m-r-s/hearingaid-prototype/signatures/README.md

Here only the GPG signatures are deployed.
If you don't know what this is, then you probably don't need them.

If you are looking for the image files:
https://github.com/m-r-s/hearingaid-prototype/wiki/Image#download
