m-r-s/hearingaid-prototype/images/controllerlayout.jpg

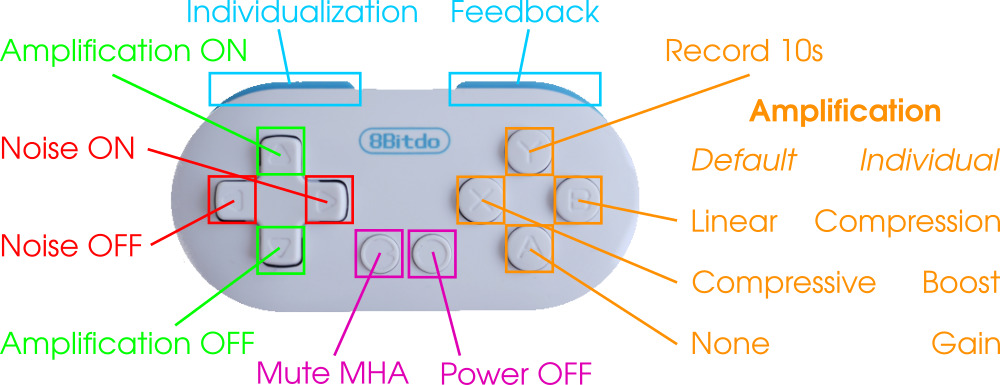
images/controllerlayout.jpg
