m-r-s/hearingaid-prototype/images/feedback-compensation.jpg

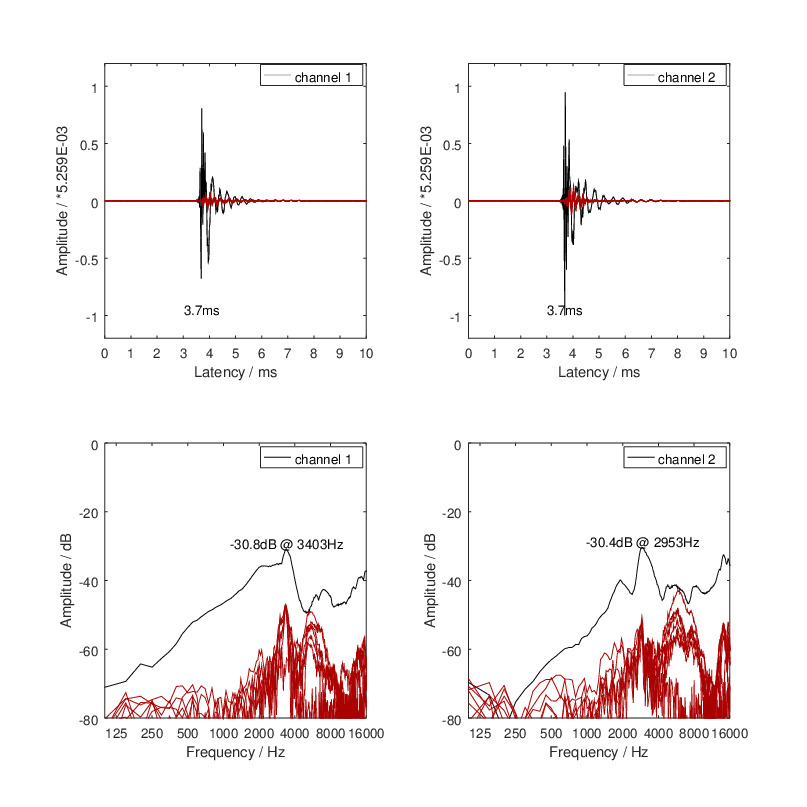
images/feedback-compensation.jpg
