m-r-s/hearingaid-prototype/images/feedback-example.jpg

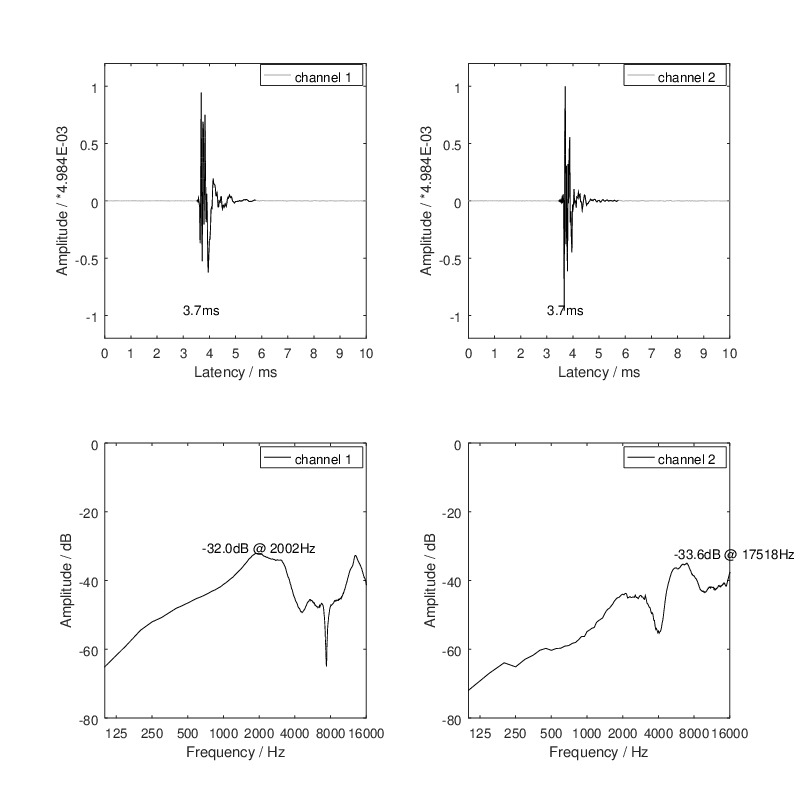
images/feedback-example.jpg
