m-r-s/hearingaid-prototype/images/feedback-relocate.jpg

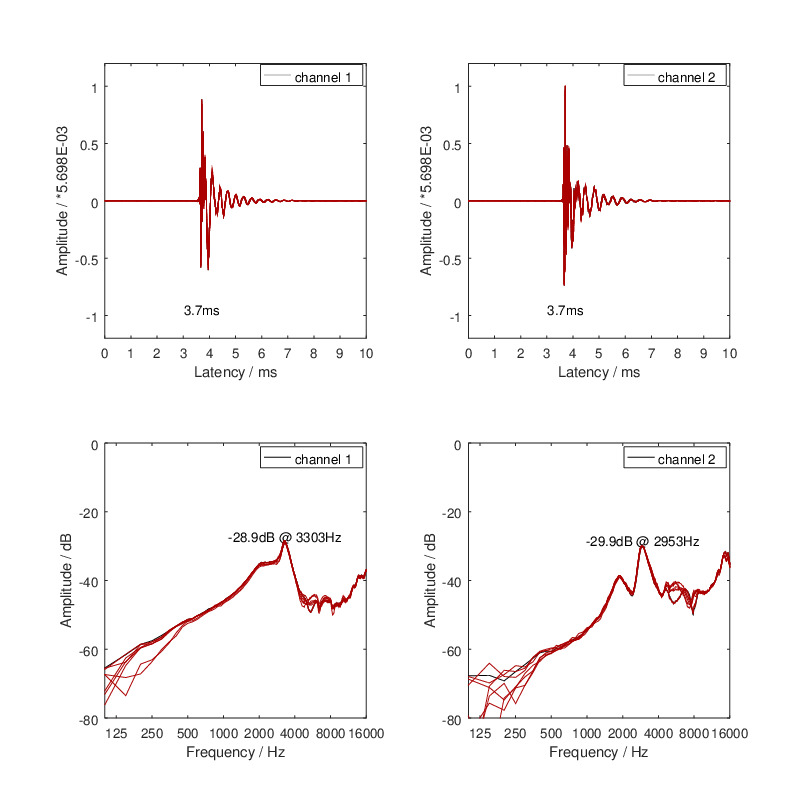
images/feedback-relocate.jpg
