m-r-s/hearingaid-prototype/images/gaintable.jpg

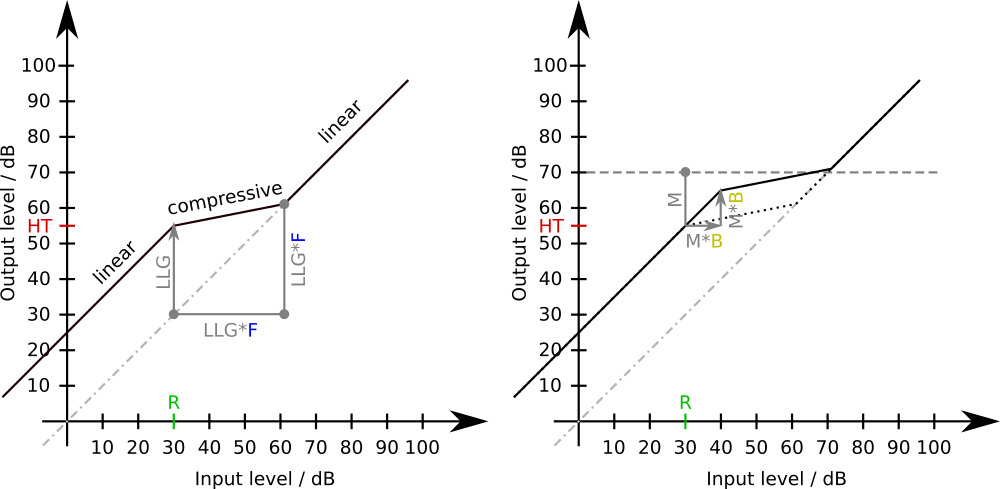
images/gaintable.jpg
