m-r-s/hearingaid-prototype/images/impuls_responses_img.png

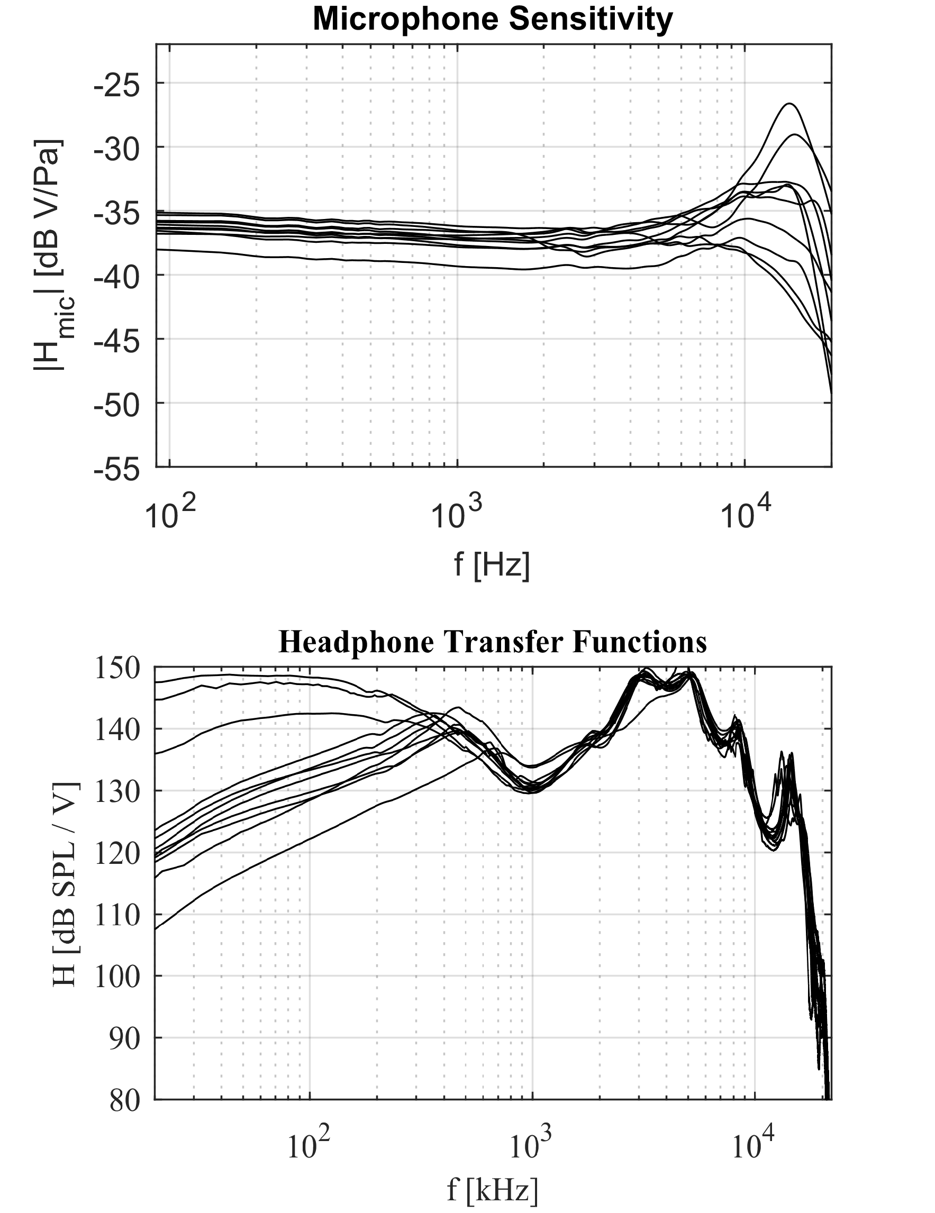
images/impuls_responses_img.png
