m-r-s/hearingaid-prototype/images/inout.jpg

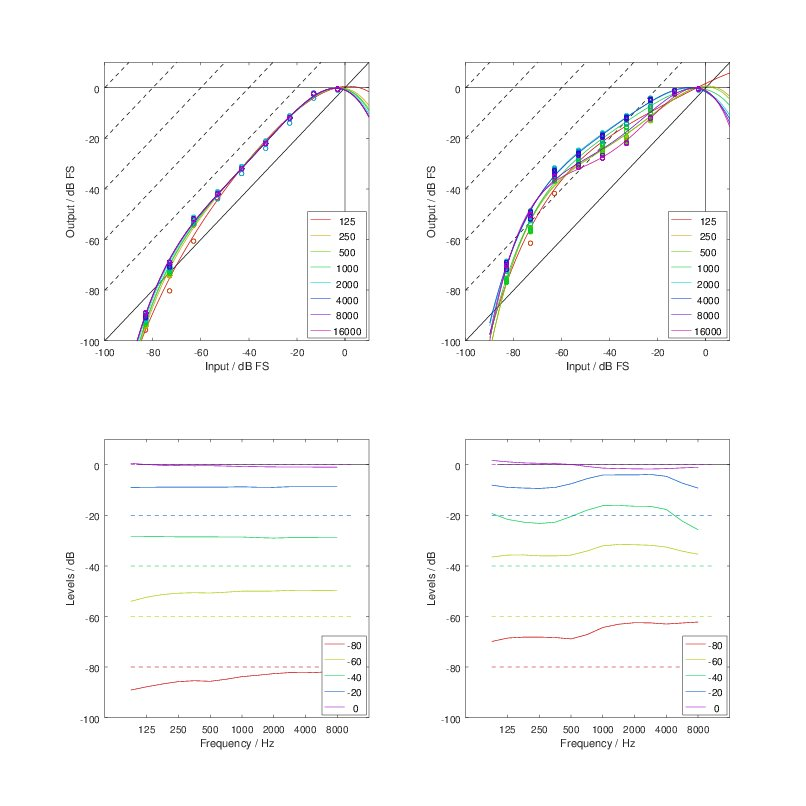
images/inout.jpg
