m-r-s/hearingaid-prototype/images/max_max_error_mic.png

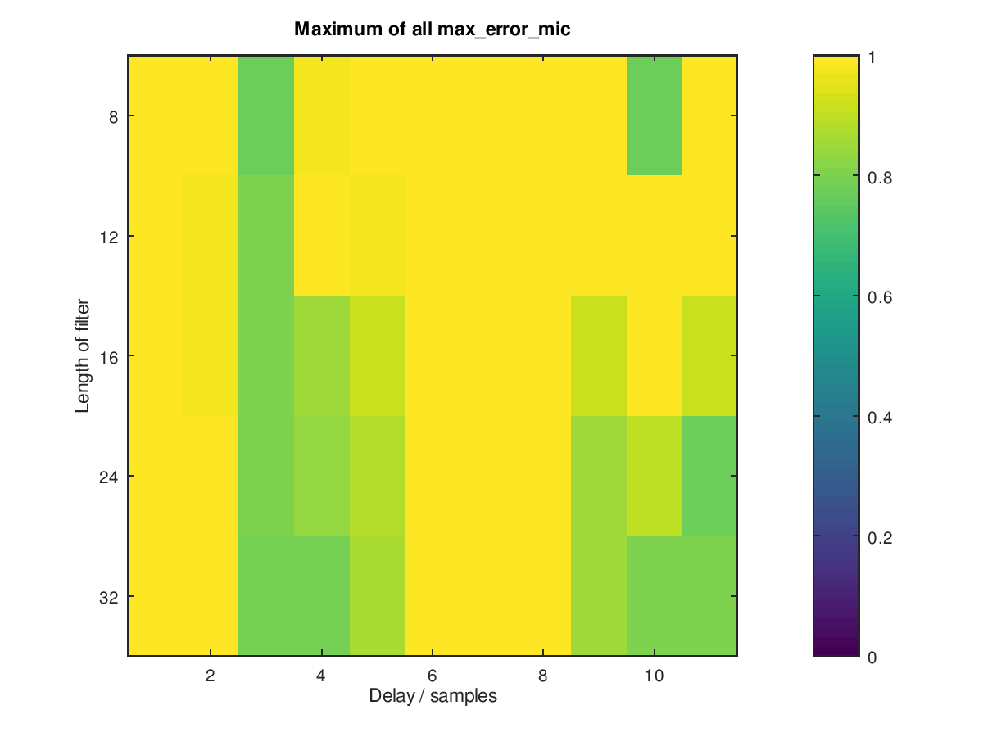
images/max_max_error_mic.png
