m-r-s/hearingaid-prototype/images/max_max_error_reiceiv.png

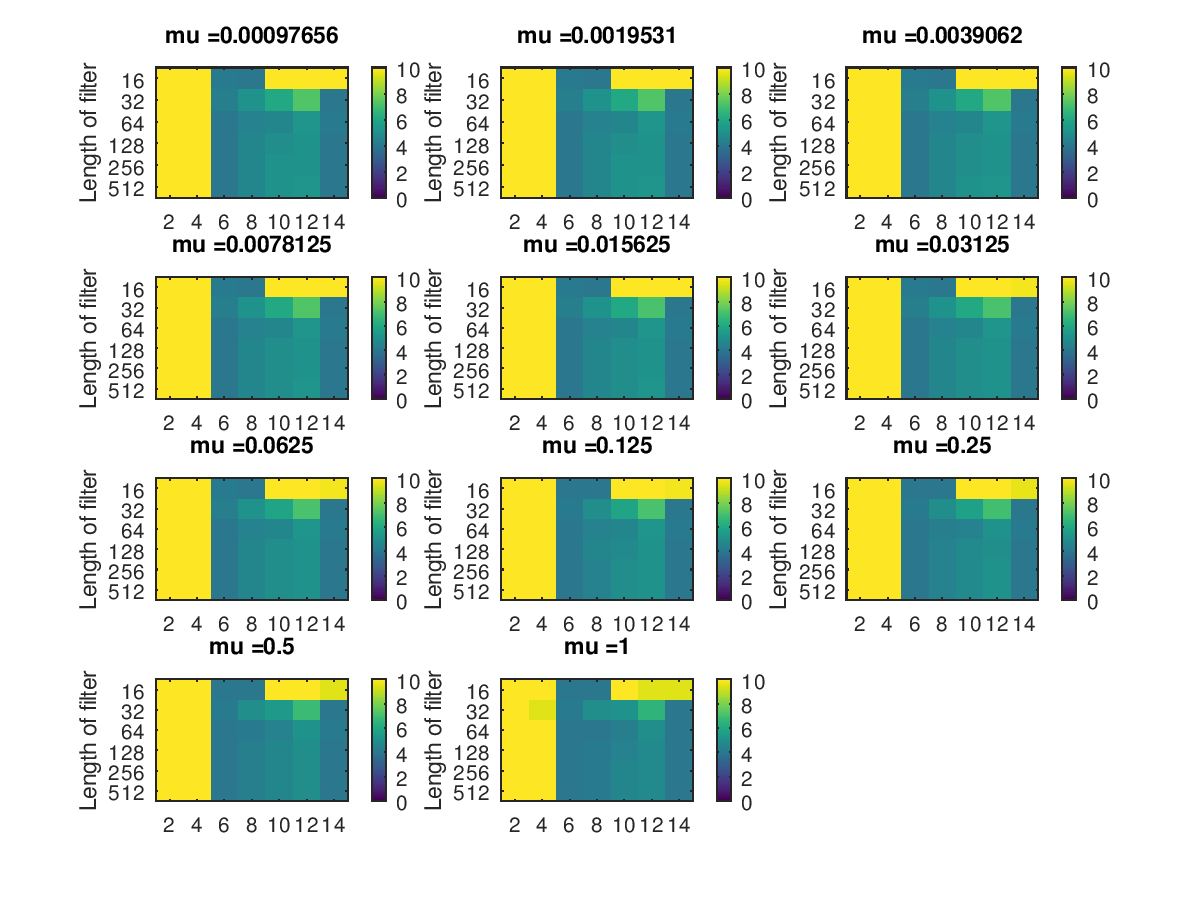
images/max_max_error_reiceiv.png
