m-r-s/hearingaid-prototype/images/mean_max_error_mic.png

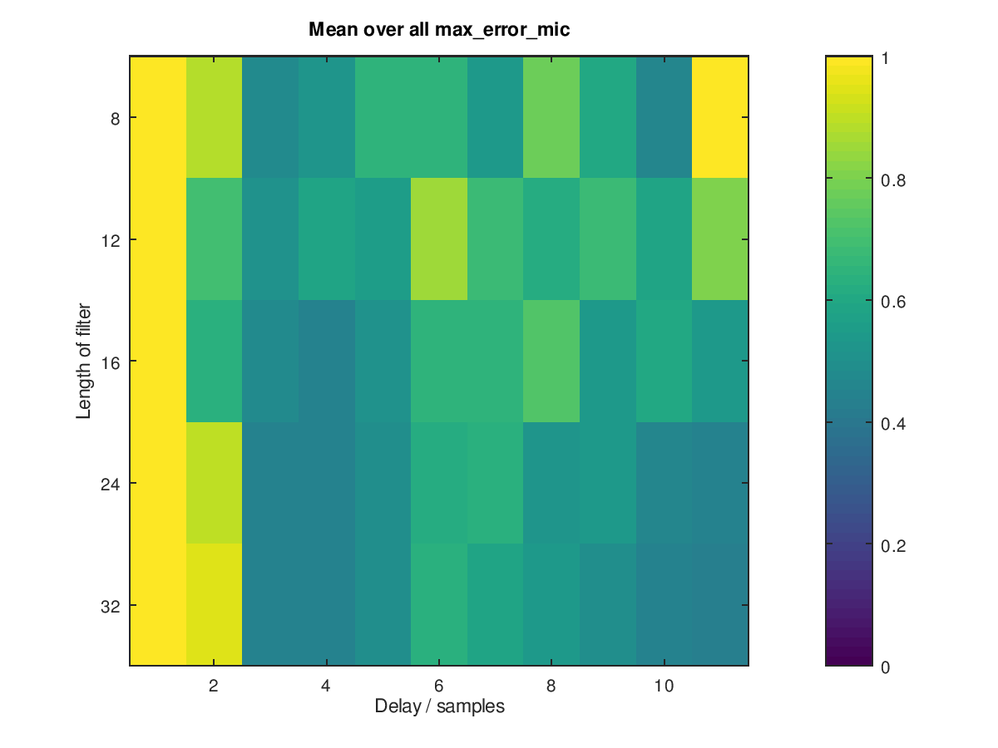
images/mean_max_error_mic.png
