m-r-s/hearingaid-prototype/images/mean_std_max_error_mic.png

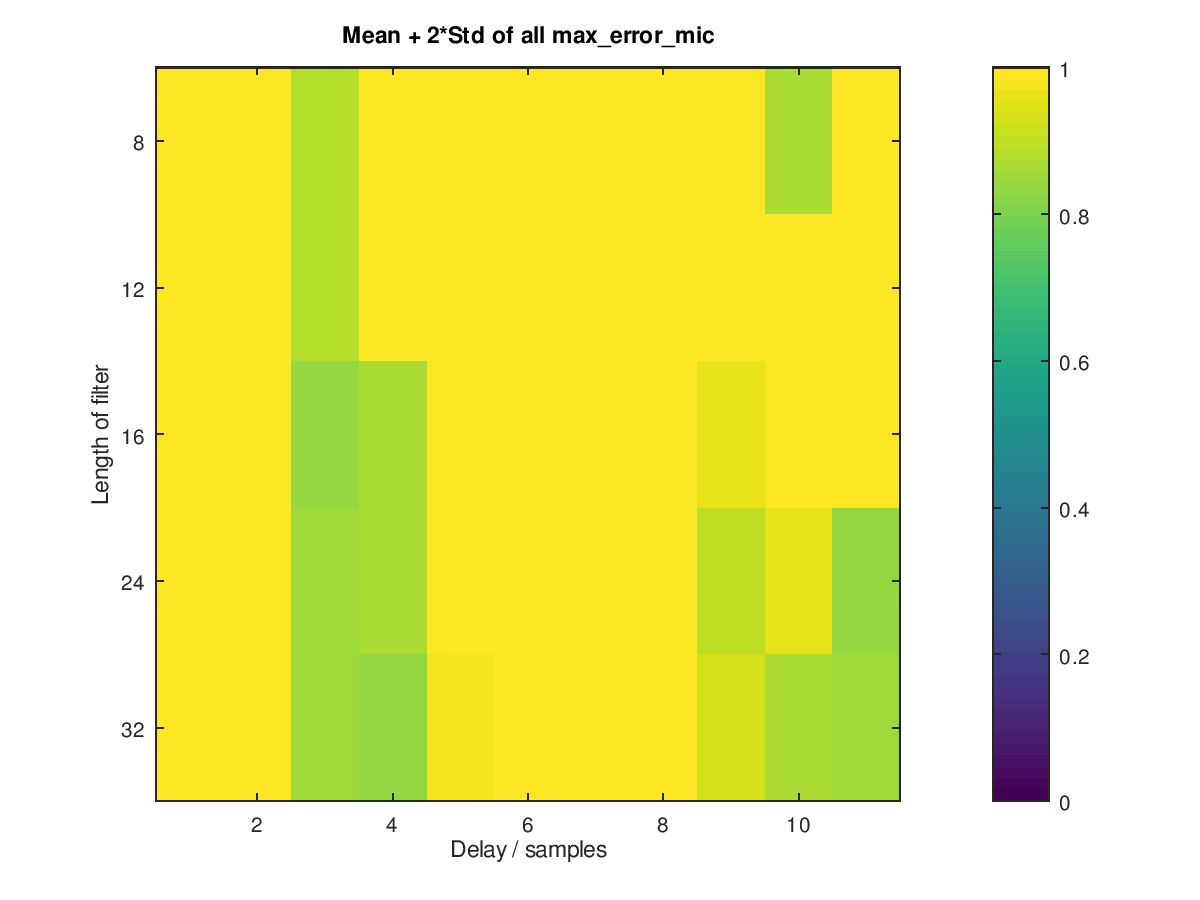
images/mean_std_max_error_mic.png
