m-r-s/hearingaid-prototype/images/pre-amplifier-circuit.png

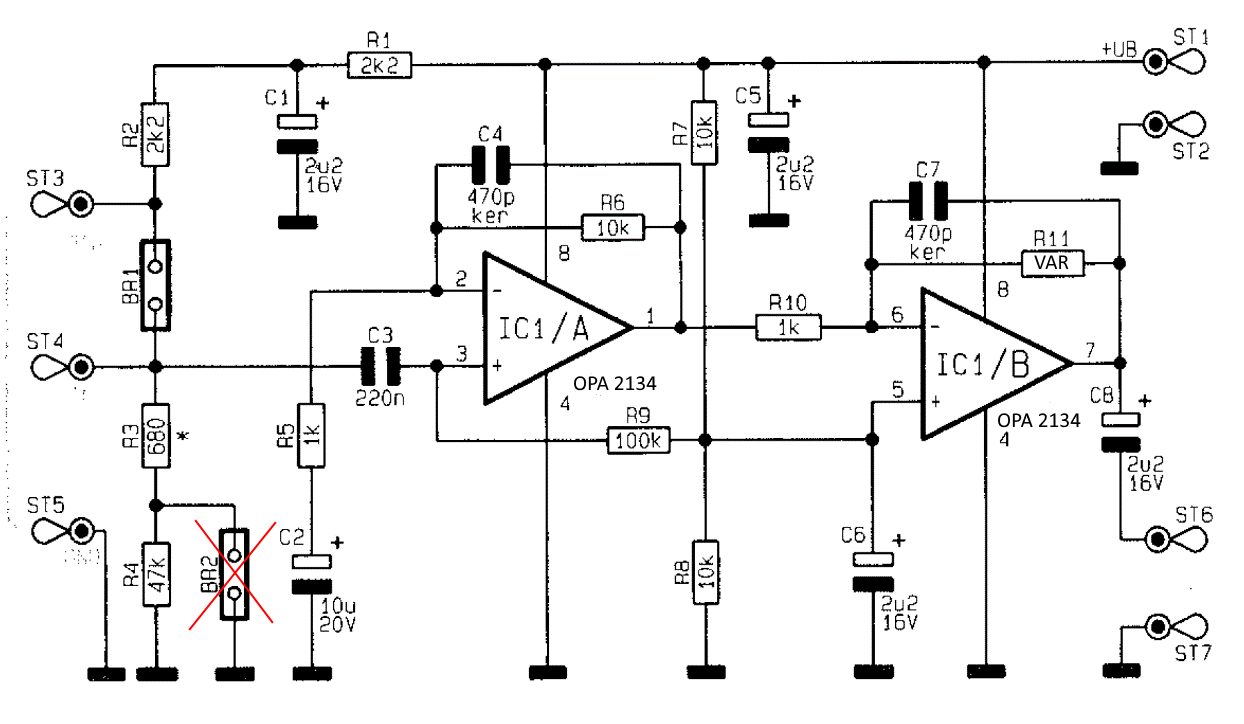
images/pre-amplifier-circuit.png
