m-r-s/hearingaid-prototype/images/pre-amplifier-open.png

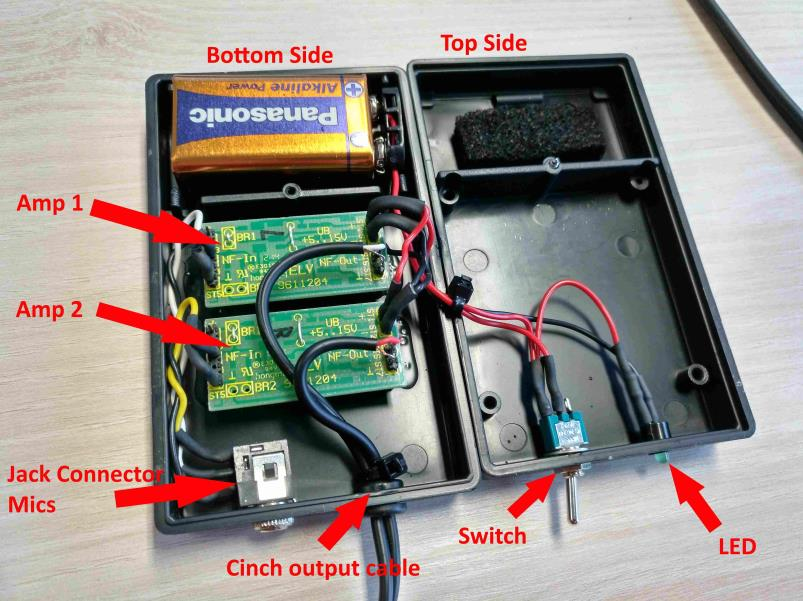
images/pre-amplifier-open.png
