m-r-s/hearingaid-prototype/images/selffitting.jpg

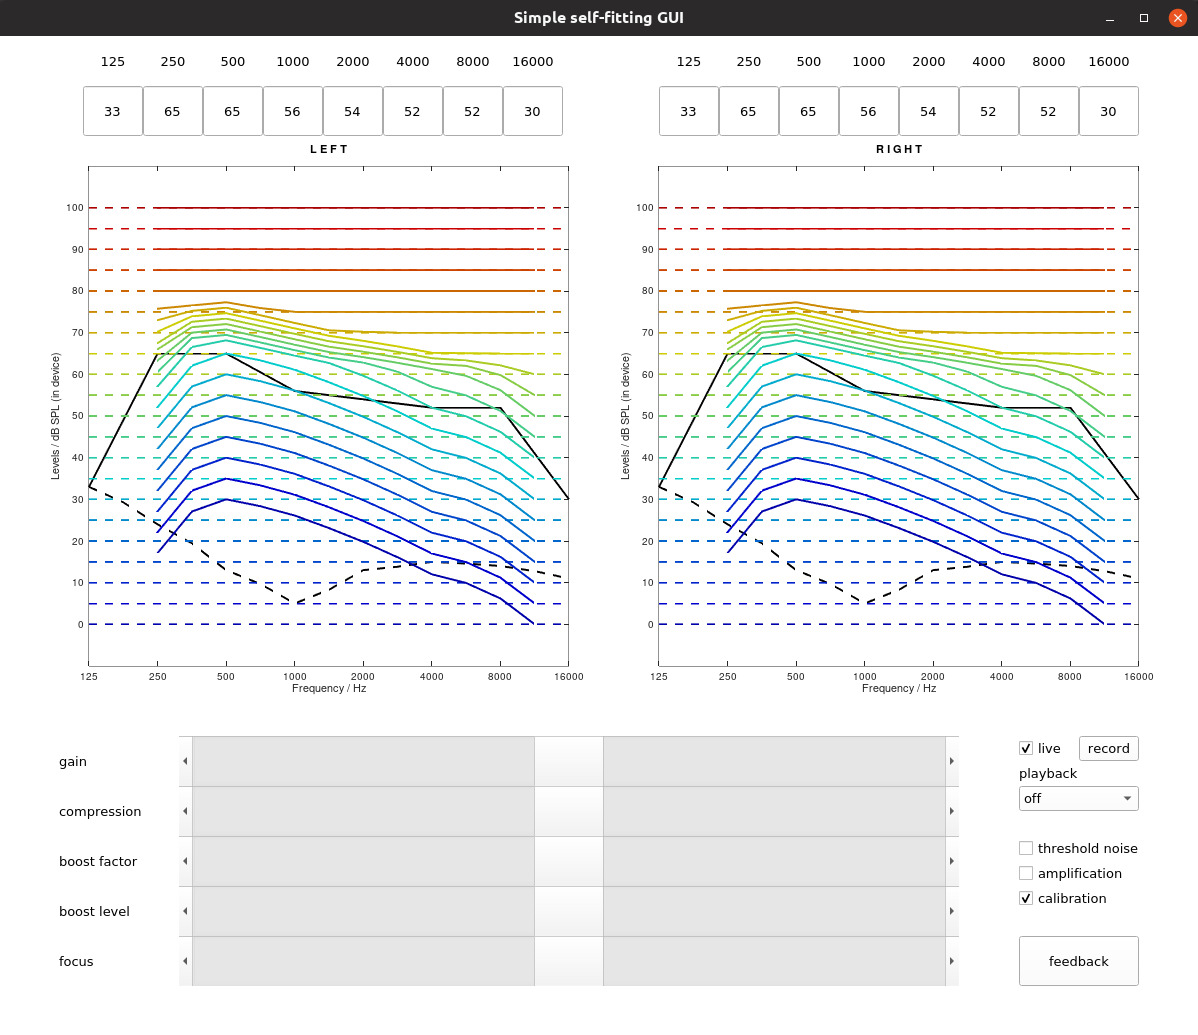
images/selffitting.jpg
