m-r-s/hearingaid-prototype/studies/jacobsen-comb-filter/grid_extended.png

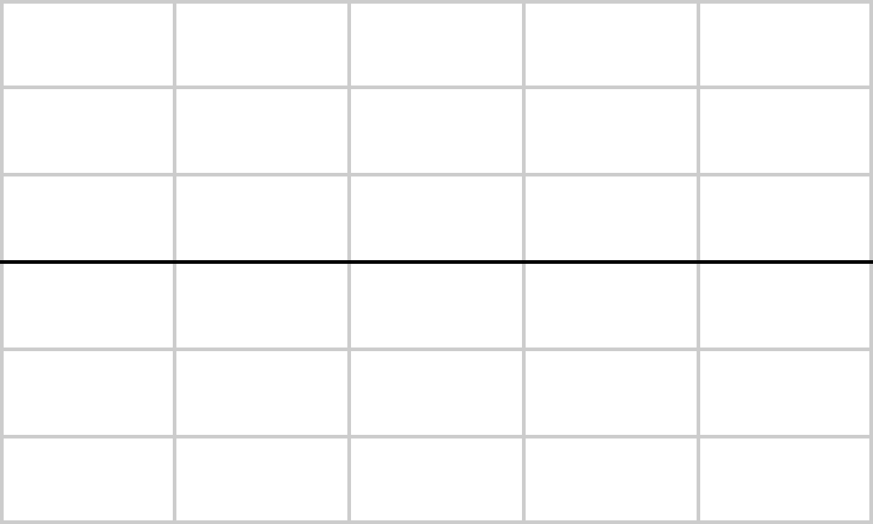
studies/jacobsen-comb-filter/grid_extended.png
