m-r-s/hearingaid-prototype/(threads)

Thread 3 (2018-01-26):

Detailed Quick start

Prototypemax, 2018-01-26:
Moin Marc,
habe gerade versucht im Wiki die Seite "Detailed Quick start" zu erstellen. Bekomme allerdings den Fehler 404 bei speichern der Seite und Github schlägt mir vor, dich zu kontaktieren. Vielleicht weißt du ja weiter?

Lg
Max

m-r-s, 2018-02-22:
Läuft jetzt :)

Closed 2018-02-22.

Thread 4 (2018-05-12):

Recommend mic and pre-amp?

atuyosi, 2018-05-12:
I'm newbie in hearing aid development and aundio I/F.

I bought audio injector, and set up with Raspberry Pi .

I'd like to know the recommended microphone and amplifier (mobile ready).

Also, audio Injector has ECM type mic, is there any problem with this mic?

suaefar, 2018-05-14:
The recommended mic and our semi-custom pre-amplifier are detailed in [the wiki](https://github.com/m-r-s/hearingaid-prototype/wiki#hardware-list)

The problem with the Injector-mic is that it does not record the sound pressure level close to the ear.

atuyosi, 2018-05-14:
Thank you for quick response.

Perhaps I can not get an assembled kit in Japan.
I will make a substitute products by referring to the circuit diagram.

Thanks.

Thread 5 (2018-07-29):

Access Denied on Putty - headless setup

JohnAbarro, 2018-07-29:
I keep getting access denied on the putty, even just by following the default username:pi password raspberry setup. I even tried the german keyboard version. I've set the putty to ssh(port 22). If it helps, I only have the pi connected to our router's lan and accessed it via wifi. I have also extracted the image through 7zip, and got a file about with a size of 3GB. I flashed the image using etcher.

JohnAbarro, 2018-07-29:
I just found this detailed quick start page which explains a different and more concise method of getting there. The link: https://github.com/m-r-s/hearingaid-prototype/wiki/Detailed-Quick-start
I have repetitively and exhaustively been trying the instructions set up on another page:
https://github.com/m-r-s/hearingaid-prototype/wiki/Instructions

I just want to inform anyone who runs into this sort of problem to use the detailed quick start. I have not tested this myself atm as I am currently downloading the image again and flashing it once more. I'll get back to my response if I found no luck.

m-r-s, 2018-07-30:
The default passwords (for WiFi and SSH) are mentioned on [Home](https://github.com/m-r-s/hearingaid-prototype/wiki#defaults)-page.
For SSH it is "openmha" instead of "raspberry".
I put the corresponding sentences now in bold letters

The [Instructions](https://github.com/m-r-s/hearingaid-prototype/wiki/Instructions) are thought for someone who has very good knowledge of the GNU/Debian/Linux environment and wants to set up **everything** rather than using the SD-card image.
I won't recommend it if you are just looking to get things working for the first time.

To help in that process we came up with the [Detailed Quick Start](https://github.com/m-r-s/hearingaid-prototype/wiki/Detailed-Quick-start)-page.
I added a link to the detailed quick start page so that it is easier to find.
Your feedback is very welcome.
You can and are encouraged to change the WIKI-pages if you find mistakes.

Thread 6 (2018-08-05):

Running OpenMHA without the bluetooth controller

JohnAbarro, 2018-08-05:
Is it possible to install OpenMHA on pi without setting up the bluetooth controller? It appears to be method for directly adjusting some parameters, but for the configuration, we plan to make any sort of adjustments through wifi connection only. I would like to know if it will run without the bluetooth script. Thank you :)

m-r-s, 2018-08-05:
Yes, of course. We added it just to demonstrate the possibilities.

The [Bluetooth control script](https://github.com/m-r-s/hearingaid-prototype/blob/0.8/tools/control/actions.sh) by default looks for the device "/dev/input/js0" and interprets its output.
But if the device does not exist everything will work just fine.
This purpose of this project is to provide a functional configuration which you can then adapt to your needs.
You can also remove [start.sh](Line 58 from https://github.com/m-r-s/hearingaid-prototype/blob/master/start.sh#L58) in your setup to avoid that the "Bluetooth script" ever interferes with your configuration.

May I ask what your plans with the prototype are?

JohnAbarro, 2018-08-05:
We would like to implement a hearing aid algorithm using OpenMHA on pi for our undergraduate thesis project. As you can see, we have little experience with using raspberry pi or linux, but somehow we are able to get by through online resources/tutorials. We appreciate how well-documented and detailed everything is with OpenMHA (we've done some perusing with the manuals), we only struggle with unfamiliarity. Thank you for being responsive and active as well! :)

m-r-s, 2018-08-06:
Cool, I like that you want to use it in a scientific context :)
However, I think this could be very challenging for an undergraduate thesis project.

You have to distinguish **this** project ([https://github.com/m-r-s/hearingaid-prototype](https://github.com/m-r-s/hearingaid-prototype)) and the openMHA project ([https://github.com/HoerTech-gGmbH/openMHA](https://github.com/HoerTech-gGmbH/openMHA)).
**This** project only wants to demonstrate how far one can come with the right free and open source software tools and enable others to achieve the same, but the openMHA software is not developed here.
We are only users.

JohnAbarro, 2018-08-07:
It is quite a big undertaking to use the software for the algorithm implementation, especially since we're all new to every single part of what we are studying. There's a bunch to cover in just months, and we've barely scratched the surface for weeks. It still seems possible to do, though.

If I understood the difference correctly, the OpenMHA is the main open source software project for hearing aids which could be used on computers running linux, mac os, or even windows, and the hearingaid-prototype project uses this software in a way that it is configured for the raspberry pi setup shown. I'll take note of the difference when referencing the two projects.

suaefar, 2018-08-27:
Yes, correct. This project only shows as an example how openMHA could be used in a mobile setup.
It also aims to motivate and help those who want to build something similar.

Thread 7 (2018-08-05):

compile error from cloned openMHA

JohnAbarro, 2018-08-05:
Hi again! I'm trying to compile openMHA and install it. but I get a missing header file error for not being able to find sndfile.h
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

I simply used the git clone command, cd openMHA, then wrote the ./configure && sudo make
I also tried ./configure && make
am I supposed to get the file(s) elsewhere?
it is most likely that I'm doing something wrong. If so, please tell me.

pmaanen, 2018-08-05:
sndfile.h is part of of the external dependency libsndfile. The corresponding package is named libsndfile1-dev. You can install it with apt-get:
> sudo apt-get install libsndfile1-dev.
Before you continue best make sure you also have the other dependencies installed:
- libjack-jackd2-dev
- jackd2
- portaudio19-dev

JohnAbarro, 2018-08-07:
I might have missed this along the way, but it certainly fixed the problem. Sorry for the trouble but, I'd like to know if I'm somewhat doing this right. Currently, I am unable to physically test the ports, so I am a lot more blind to what is currently happening. Though I think I managed to autostart the program by means of adding a few lines in .bashrc, I feel uncertain about my configurations. I tried to execute these lines manually on the terminal instead of executing them through .bashrc. Currently, I've been flooded with these repetitive lines which I am oblivious to what it means.
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
I'm clueless if these lines are normal. I also decided to check up on my connections through njconnect, and once again, I am not sure if I'm getting the appropriate results.
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
If it helps to know, I am using the audio injector octo sound card, which I believe our pi could detect as it shows up in the lists like aplay -l. But aside the soundcard used, I would just like to know if I'm doing it right at this point or if I missed anything crucial. Thank you :)

fotisdr, 2018-11-19:
Hello all,

I'm also trying to setup the openMHA with a Raspberry Pi 3+ and a Cirrus Logic audio card and I am having the same problem. During boot I get some noise played back through my headphones (or the text2speech message) but I keep getting these XRun errors (e.g. pinknoise/thresholdnoise/abhang/mha was not finished) and the calibration procedure stops at different points each time until I break it with Ctrl+C.
I've tried increasing the buffer lenght of jackd but no improvement. Do you have any experience with this?

m-r-s, 2018-11-19:
Hi!

The causes of XRuns can be manifold.
Here is a list of things which can influence the performance [1].

Given, that the features of the sound cards are similar, it could also be due to a inadequate fragment size [2]. I don't remember now if you can just double it. Try with FRAGSIZE=96 instead of 48, and with NPERIODS=4 instead of 2.

Also, I think it is unavoidable that there are some XRuns at the beginning.
> A few of them are normal. They happen when the system is busy working on interrupts from the wifi/network/usb. Hence, while using the device (after the configuration) wifi/network/usb usage should be avoided.

Are you using a display or are you connected via ssh (wifi or LAN)?
Do the XRuns appear when the cursor blinks?

Also, do you have a microphone amplifier with a gain of approx. 36 dB?
If not, the feedback cancellation might do awkward things (which it will also if the latency of the feedback exceeds 20ms [3]).

To help you I need much more specific explanations of what you exactly did and what the result was.
If you want to find out more, I would suggest to try running jackd without all the stuff, that the script starts.
Just comment out the line in the .bashrc which auto-starts the script, reboot and then try to "optimize" jack [4]. i.e, find settings which run without XRuns.

Best wishes,
Marc

[1] http://www.manual.ardour.org/setting-up-your-system/the-right-computer-system-for-digital-audio/
[2] https://github.com/m-r-s/hearingaid-prototype/blob/1.1/start.sh#L17
[3] https://github.com/m-r-s/hearingaid-prototype/blob/1.1/tools/abhang/src/core/constants.h#L17
[4] https://wiki.linuxaudio.org/wiki/optimize_jack

fotisdr, 2018-11-19:
Hi Marc,

Thanks for the prompt reply!

I was hoping to test the openMHA prototype at first so I don't have the complete setup (I am using a headset without an amplifier). I thought that it will be possible to try this out with a headset. I am also connected to the raspberry pi through a display, does this make a difference?

To be more specific, I've tried running the jackd command alone and it runs without any XRun errors with the default settings (fragsize=48 and nperiods=2). So, I guess that this might be something related to my setup and the calibration during boot. Is there a way to make this work without the suggested earphones and amplifier for now?

Best wishes,
Fotis

m-r-s, 2018-11-19:
No, probably not without fundamental modifications.

You can get openMHA running, but most probably you will need to adapt the openMHA configuration to match your setup (i.e., number of input/output channels, compensation filters, calibration, ...).
However, I doubt that my static feedback cancellation hack would work in that case.
If I were you, I would use the SD-card image but start from scratch by setting up openMHA.
OpenMHA is well documented [1,2].

Best wishes,
Marc

[1] https://github.com/HoerTech-gGmbH/openMHA/blob/master/openMHA_application_manual.pdf
[2] https://github.com/HoerTech-gGmbH/openMHA/blob/master/openMHA_calibration_manual.pdf

fotisdr, 2018-11-20:
Hi Marc,

Thanks a lot for your help. I set up the openMHA after all from your SD-card image by bypassing your static feedback algorithm, I'm now trying to find out how to make the various algorithms work.

Best,
Fotis

Gartenmmeisen, 2018-12-04:
Hey, I also got the XRUN-Issue (picture) trying to set it up with the SD-Card Image for my graduate internship.  I have basically the same setup as recommend,  though using a display and a keyboard.
Any recommendations for me?

best wishes,

Marten

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

m-r-s, 2018-12-04:
It is normal that you get some XRUNs while the device is still booting.
If you don't get XRUNs every second after the whole boot process finished, it should be fine.
Do you get XRUNs after the
`[COMMANDER] range2 = [X Y]`
line?

Do you hear "clicks" (every second or more often) in the reproduced signal?

Best wishes,
Marc

Gartenmmeisen, 2018-12-04:
Okay thanks for the fast reply.
No error after the range and no clicks. Just the text2speech and the sound finally stops.
So it probably works fine.

best,
Marten

Thread 23 (2019-05-23):

how to run openMHA plugins

Gumilar92, 2019-05-23:
Hello,

im really new to openMHA, but currently working for preperation of my bachelor-thesis on a jack-based audio processing client. which is intended to developed a simulator of hearing aid device. and then my prof recommended me to learn this software, and hoping that i can create my own plugins (dunno what it means, but maybe apply my own algorithm in openMHA client).

i can already run my own algorithm in this hearing aid prototype, but how do i create plugins and runs it ?

thanks for the answer in advance

m-r-s, 2019-05-23:
Hi!

I am very happy to hear that you were able to implement you own ideas based on our prototype.
That was the very idea when we decided to publish it.

I wrote a jack client myself (like you did), but I did not find the time to put the code in a openMHA plugin.
The main advantage would be to be able to change parameters while the signal processing is running and the possibility to combine your processing with other MHA plugins.

If I were you, I would start here [1], where the openMHA project provides example code.
Maybe looking at the code and the corresponding description in the developer manual [2] you might find a way.

I hope this helps.

Best wishes and good luck,
Marc

[1] https://github.com/HoerTech-gGmbH/openMHA/tree/master/examples/00-gain
[2] https://github.com/HoerTech-gGmbH/openMHA/blob/master/openMHA_developer_manual.pdf

Thread 24 (2019-09-10):

how to install this plugin?

dhanashri-innovision, 2019-09-10:
Hi,
We have tested the openmha on our windows PC. It works fine. Now we want to install your plugin. How to do it?

m-r-s, 2019-09-10:
Hi,

which plugin do you mean?

Here, we offer instructions how to install and run openMHA on a Raspberry Pi based hearing aid prototype plus a pre-configured SD-card image to do so.
We only use the standard openMHA plugins.

dhanashri-innovision, 2019-09-11:
Hi,
I want to test m-r-s hearing aid with the .wav file on my PC, with openMHA but without Raspberry Pi prototype.
so for that I will have to install these prototype. can you direct me?

m-r-s, 2019-09-11:
The idea of this repository is to give you instructions on how to build your own physical, wearable hearing aid prototype, but not about running openMHA on a PC.

I would not recommend that, but if you really want to run the prototype-openMHA-config on your PC you could just use the provided [openMHA.cfg](https://github.com/m-r-s/hearingaid-prototype/blob/master/openMHA.cfg) with openMHA.
However, this is a very basic configuration which only runs a dynamic compressor with all gains set to zero.
Also, you then need to make sure that you properly calibrated your setup, c.f., [OpenMHA calibration manual](http://www.openmha.org/docs/openMHA_calibration_manual.pdf)

Closed 2019-09-11.

Thread 26 (2020-05-19):

(mhafw_lib) IO error: (mhajack) Unable to connect to JACK server 'default' as client 'MHA'.

chozillla, 2020-05-19:
I had this issue when I tried to run gain_live_getting_started.cfg. I deleted jack2 and redownladed it.
Another separate issue that prompted me to delete jack2 in the first place is how do you set the buffer size in Jack? Jack had it set at 512 and openMHA wanted 64.

m-r-s, 2020-05-19:
Do you want to use openMHA on your PC, or do you use our recommended setup with the Raspberry Pi 3?

If you want to learn how to use openMHA, I would recommend you to begin with the "openMHA starting guide" http://www.openmha.org/docs/openMHA_starting_guide.pdf

chozillla, 2020-05-19:
Currently running this on Mac OS Mojave. I haven’t found anything on this in the documentation

m-r-s, 2020-05-19:
Okay, this project is only about the hearing aid prototype based on the Raspberry Pi 3 platform.
We use openMHA for our project, but we can't help you with the general usage.
You might head over to the openMHA project repository where you can also find instructions how to install openMHA on Mac OS: https://github.com/HoerTech-gGmbH/openMHA/blob/master/INSTALLATION.md#ii-macos-installer
You can also open an issue over there.

Closed 2020-05-19.

Thread 37 (2021-08-09):

Preamplifier remplacement

d01010101, 2021-08-09:
The suggested preamplifier can be ordered only in few countries, then needs to be modified which includes SMD soldering. The authors say that no ready off-the-shelf preamplifier could be found. I would like to ask, what is so specific about the preamplifier? If it cannot be replaced by, say, this (one of many options):

https://www.kemo-electronic.de/en/Light-Sound/Amplifier-Splitter/Modules/M237-Stereo-Preamplifier.php?faq
9 - 24 V/DC stabilized (or battery) | Current consumption: approx. 3.4 mA ± 20% at 12 V (without load) | Frequency range: approx. 8 Hz - 60 kHz, 3 dB at U out 1.5V RMS | Input impedance: 100k Ω | Output load: > 2k Ω | Amplification: approx. 30 dB ± 20% | Distortion: ≤ 0.02% ± 20%

then what is the exact reason? Noise level? In particular, is the signal inversion of the original amplifier important? If yes, it seems like something easily modifiable in software.
