m-r-s/hearingaid-prototype/(commit log)

2017-12-11 Added openMHA config and start script and updated figure for better readibility
    [openMHA.cfg]
2017-12-21 Set initial gain of dynamic range compressor to 0dB.
    Previous settings applied high gains in some frequency bands by default.
    [openMHA.cfg]
2017-12-26 Fix openMHA config file
    [openMHA.cfg]
2017-12-26 Added example script to measure feedback, latency, and IO-functions.
    [openMHA.cfg]
2018-05-31 Reduce fragment/period to 48 samples (1ms at 48kHz) Add double buffering to config (not used but adds flexibility) Remove frequency shifter from default config Remove coherence filter from default co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
    [openMHA.cfg]
2018-05-31 Added simple static feedback cancellation
    The added programs and scripts perform the following:
    1) Play back a "white" noise and record the feedback
    2) Calculate the static feedback path
    3) Start a jack plugin which subtracts the static feedback from the input
    Some caveats:
    1) The measurement is currently at FS minus 20 dB, i.e., loud!
    2) This requires ~30s additional time on startup
    3) This won't work in loud environments where the initial measurement will fail
    4) Reinitialization is required on feedback path changes (e.g. driver hiccups)
    [openMHA.cfg]
2018-06-02 Added generic compensation filters
    [openMHA.cfg]
2018-07-14 Calibrated reference setup
    [openMHA.cfg]
2018-07-23 Correct calibration to better fit average mic sensitivity
    [openMHA.cfg]
2018-07-23 Changes on device to make new feedback estimation work
2018-07-24 Add tool to record sound samples in intervals
2018-07-27 Update feedback-image with data after calibration
2018-07-30 Add .asoundrc to create a virtual alsa device that routes sound though JACK
2018-07-30 Implement switch to turn on and of the dynamic compression via bluetooth remote Reduced level of noise to measure feedback path by 6dB
    [openMHA.cfg]
2018-07-30 Add possibility to play back wav files via MHA Enable text to speech for control via bluetooth
    [openMHA.cfg]
2018-07-30 Added different gaintables: - no amplification (nogain) - linear amplification (linear40) - compressive amplification 1 (pack2004) - compressive amplification 2 (pack2004 -10dB)
    Refactored feedback cancellation initialization (own script)
    Linked bluetooth remote buttons to load gain tables:
    A: no amplification
    B: linear amplification
    X: compressive amplification 1
    Y: compressive amplification 2
    More bluetooth buttons:
    Start: power off
    Select: MHA sound off
    Up: Enable amplification
    Down: Disable amplification
    Left: Disable threshold simulating noise
    Right: Enable threshold simulating noise
    LT: Re-estimate feedback (short, 2s)
    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
    [linear40.cfg, nogain.cfg, plack2004.cfg, plack2004low.cfg]
2018-08-14 Remove amplifier circuit
2018-08-23 Implemented menu in Octave and added individualization Added commander script to execute commands The commander is controlled via a fifo queue Added hearing threshold measurement Added individualizab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
    [A_no-amplification.cfg, B_linear-amplification.cfg, X_compressive-amplification-1.cfg, linear40.cfg, nogain.cfg, openMHA.cfg, plack2004.cfg, plack2004low.cfg]
2018-08-24 fix temporal aliasing
    [openMHA.cfg]
2018-08-29 Use compressive gain table (plack2004) lowered by 10dB
    [X_compressive-amplification-1.cfg, X_compressive-amplification.cfg]
2018-09-05 Added tools for equalization filter design
2018-09-05 Added tools for equalization filter design, part 2
2018-09-05 added data and inversion filter calculation scripts
2018-09-10 Reinclude pre-amplifier circuit after permission from ELV
2018-11-05 Fixes to inversion filter scripts for Linux
2018-12-31 Add options to record/disable live input and playback
    [openMHA.cfg]
2019-01-13 Revised calculation and visualization of input output compensation filters
2019-01-13 Remove empty files and rename mic inversion filter script
2019-01-13 Use new compensation coefficients and increase max level to 100.8 dB SPL
    Correct playback level
    Fix mhaplayback.m
    The
    level and mha play fix
    [openMHA.cfg]
2019-01-19 Add high-pass filter with 30Hz cut-off before amplification in openMHA.cfg
    [openMHA.cfg]
2019-03-12 included calibration demo to self-fitting GUI
2019-03-13 Remove conversion of levels to free-field
    Now, all levels are levels at device, i.e., the device microphone.
2019-06-03 Fix openMHA error with openMHA version 4.9.0 which constrains the combinations of double buffer input and output sizes
    [openMHA.cfg]
2020-10-27 Add new study comb-filter-comparison
2021-10-20 Add an option to commander.sh to change the calibration of MHA
    A use case is if the amplification of the preamplifier is changed.
